UCSBRoboticsClub/ViaCar-2015/cad/Imported Components/viacarbracket2/viacarbracket2.htm

Autodesk Inventor Translation Report | Friday, April 17, 2015 (7:29 PM)
Source File: | C:\Users\Nick\Documents\GitHub\viacar-2015\CAD\viacarbracket2.SLDPRT
Translator Type: | SolidWorks | Sending System:
Author: |  | Translation Time: | 00:00:00
Options
Import Type: | N/A
Entity Types to Import: | Solids, Surfaces, Wires
Import into Repair Environment: | Yes
Import Assembly as Single Part: | No
Create Surfaces As: | Single Composite Feature
Check Parts during Load: | No
Auto Stitch: | No
Enable Advanced Healing: | N/A
+/- | Name | Inventor File | Status
[+] [-] | viacarbracket2.ipt | C:\Users\Nick\Documents\GitHub\viacar-2015\CAD\Imported Components\viacarbracket2\viacarbracket2.ipt | Error
Severity | Entity Id | Message
Error | 0 | Translation failed. This version is not supported.
