UCSBRoboticsClub/ViaCar-2015/cad/Flag mount/Assem1.SLDASM

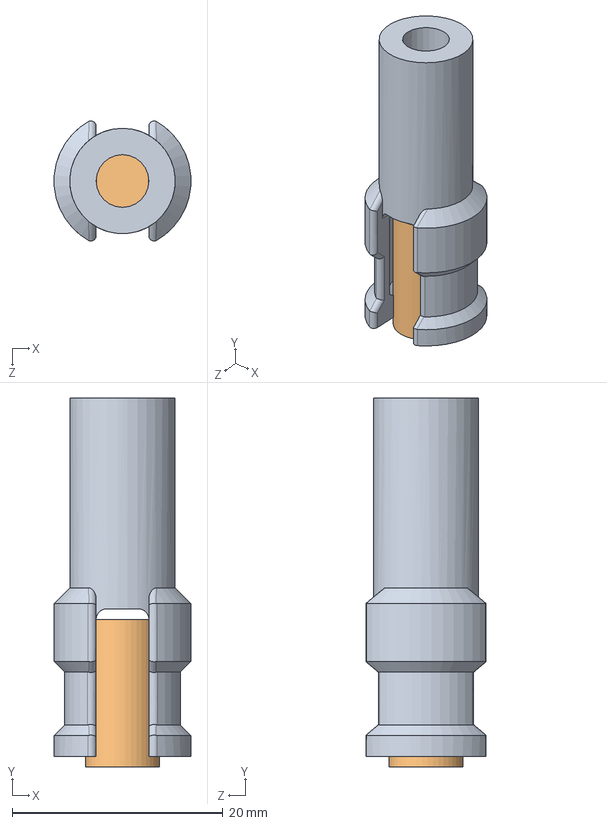
[picture p1: CAD file, 2015-04-11]
cad/Flag mount/Assem1.SLDASM
13.0 x 35.0 x 11.4 mm
flag mount
Switch
