UCSBRoboticsClub/ViaCar-2015/cad/Body to electronics Bracket/main board.SLDPRT

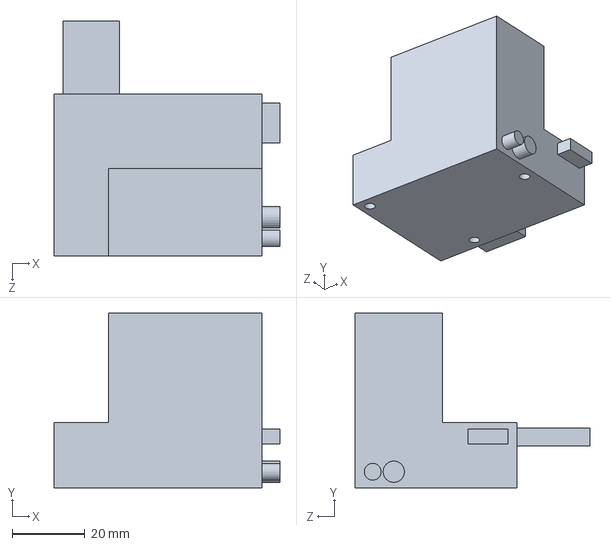
[picture p2: CAD file, 2015-04-11]
cad/Body to electronics Bracket/main board.SLDPRT
62.0 x 48.0 x 64.5 mm
