UCSBRoboticsClub/ViaCar-2015/cad/Body to electronics Bracket/via car loosey goosey.SLDASM

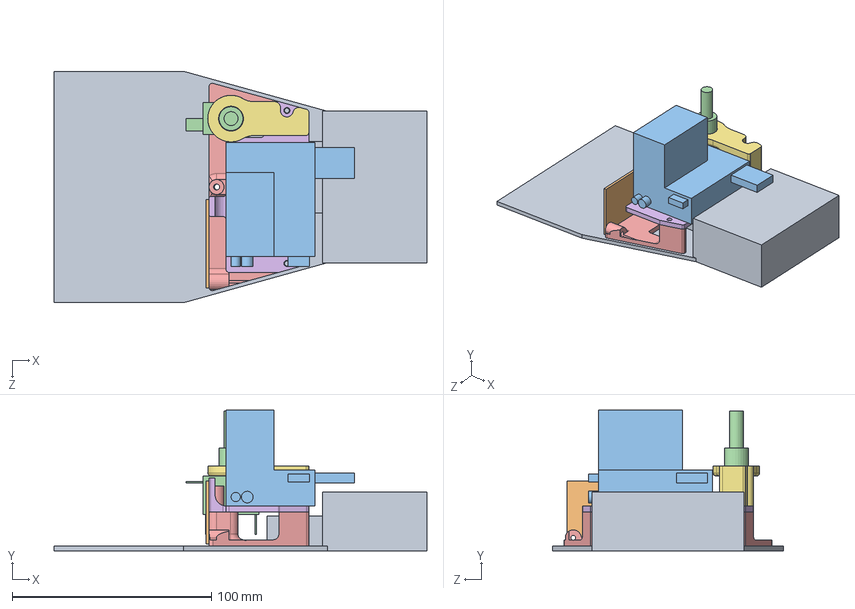
[picture p3: CAD file, 2015-04-11]
cad/Body to electronics Bracket/via car loosey goosey.SLDASM
187.0 x 70.5 x 116.0 mm
Car approximation
motor driver
main board
Kill switch
bracket bottom layer
bracket middle layer
bracket top layer
