UCSBRoboticsClub/ViaCar-2015/cad/Body to electronics Bracket/bracket.SLDPRT

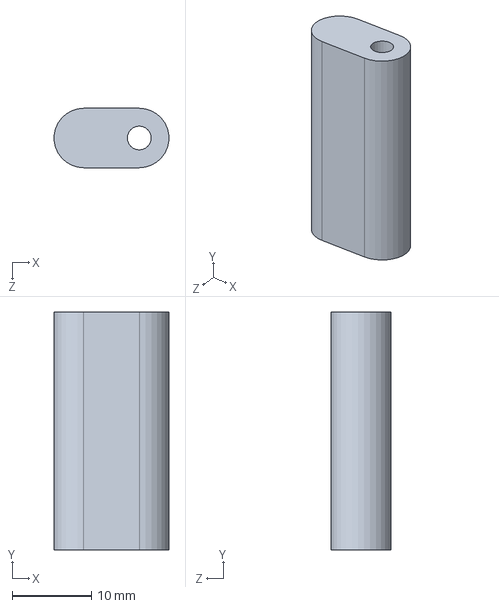
[picture p4: CAD file, 2015-04-11]
cad/Body to electronics Bracket/bracket.SLDPRT
14.5 x 30.0 x 7.50 mm
