UCSBRoboticsClub/ViaCar-2015/cad/Flag mount/flag mount.STEP

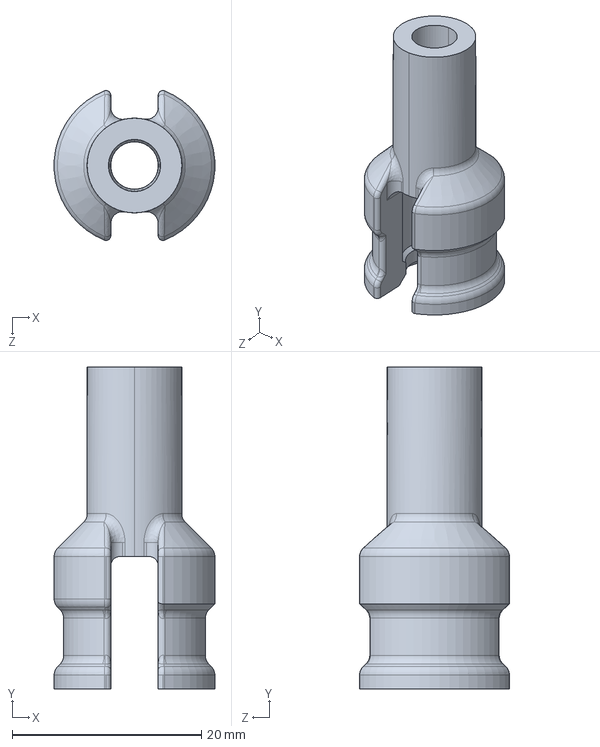
[picture p5: CAD file, 2015-04-18]
cad/Flag mount/flag mount.STEP
17.0 x 34.0 x 15.8 mm
