UCSBRoboticsClub/ViaCar-2015/cad/rulerbracket.STEP

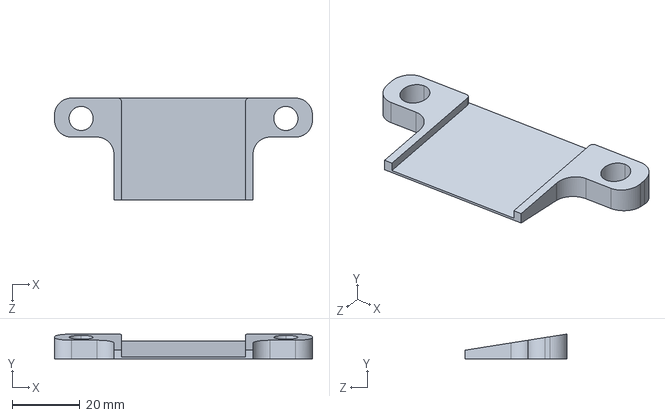
[picture p6: CAD file, 2015-04-18]
cad/rulerbracket.STEP
76.0 x 7.34 x 30.0 mm
