UCSBRoboticsClub/ViaCar-2015/cad/Body to electronics Bracket/Car approximation.SLDPRT

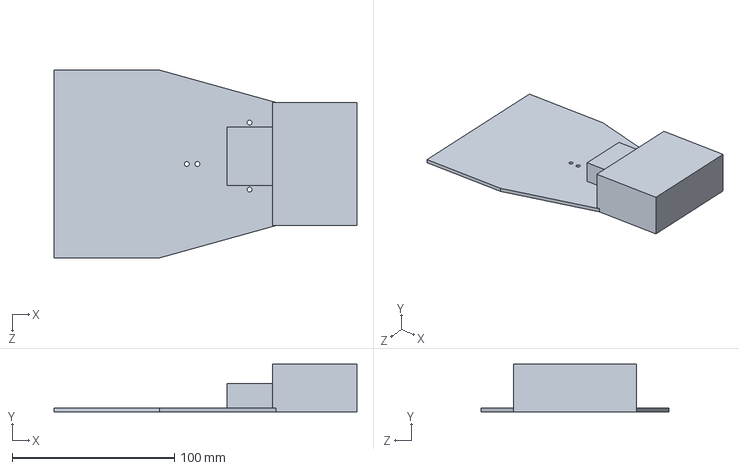
[picture p7: CAD file, 2015-04-11]
cad/Body to electronics Bracket/Car approximation.SLDPRT
187.0 x 29.5 x 116.0 mm
