UCSBRoboticsClub/ViaCar-2015/cad/viacarbracket2.SLDPRT

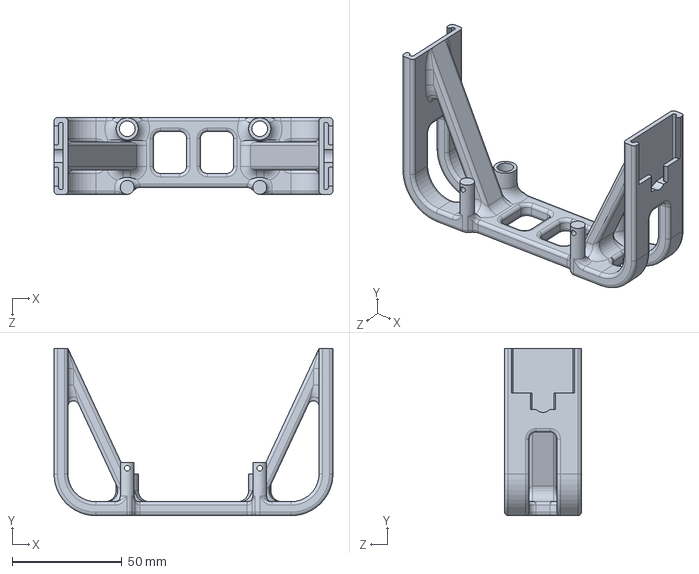
[picture p8: CAD file, 2015-04-07]
cad/viacarbracket2.SLDPRT
127.0 x 76.2 x 34.9 mm
