UCSBRoboticsClub/ViaCar-2015/cad/Body to electronics Bracket/bracket bottom layer.STEP

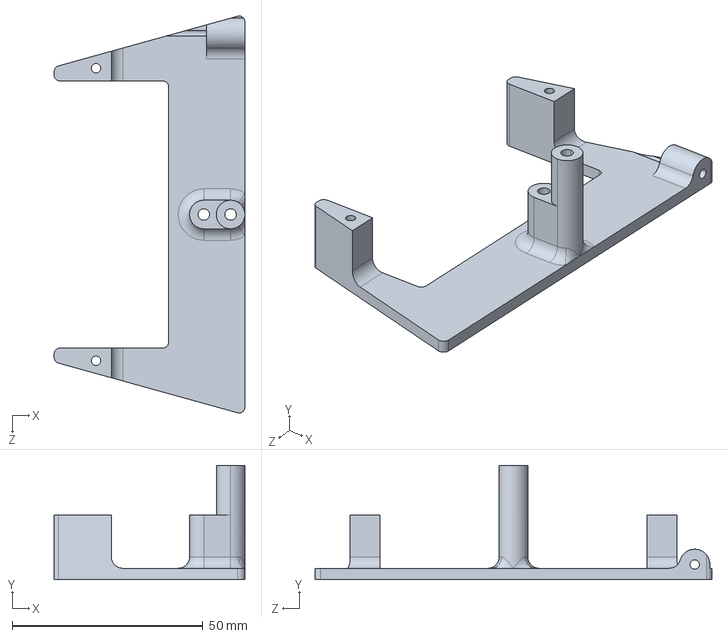
[picture p9: CAD file, 2015-04-11]
cad/Body to electronics Bracket/bracket bottom layer.STEP
50.0 x 30.0 x 104.1 mm
