UCSBRoboticsClub/ViaCar-2015/cad/Flag mount/Switch.SLDPRT

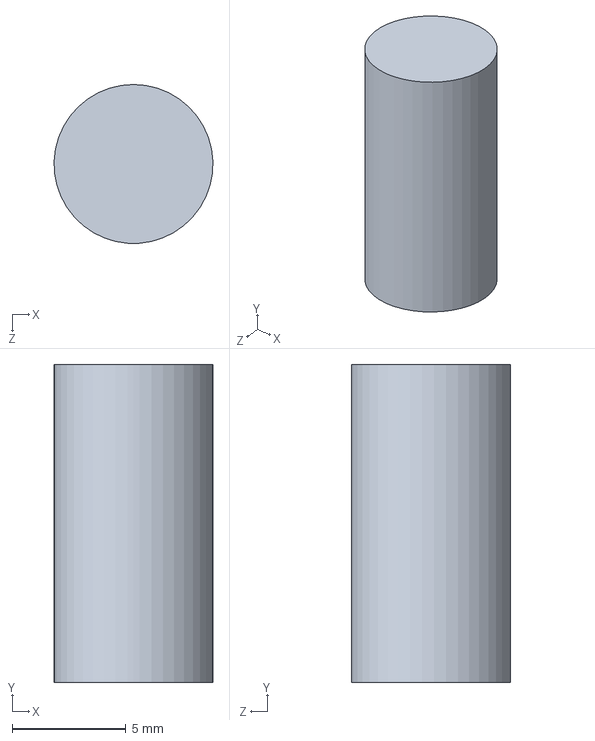
[picture p10: CAD file, 2015-04-11]
cad/Flag mount/Switch.SLDPRT
6.99 x 14.0 x 7.00 mm
