UCSBRoboticsClub/ViaCar-2015/cad/viacarbracket.stl

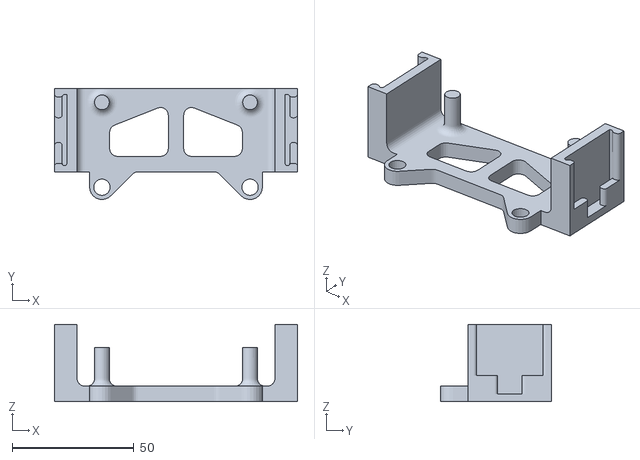
[picture p11: CAD file, 2015-04-05]
cad/viacarbracket.stl
100.0 x 45.7 x 31.8
