UCSBRoboticsClub/ViaCar-2015/cad/Body to electronics Bracket/motor driver.SLDPRT

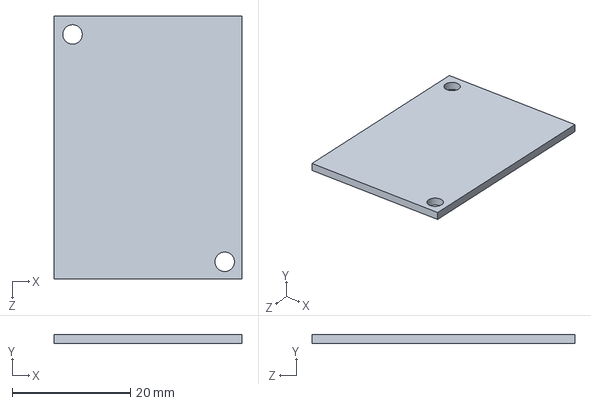
[picture p12: CAD file, 2015-04-11]
cad/Body to electronics Bracket/motor driver.SLDPRT
31.7 x 1.60 x 44.4 mm
