UCSBRoboticsClub/ViaCar-2015/cad/Body to electronics Bracket/Kill switch.SLDPRT

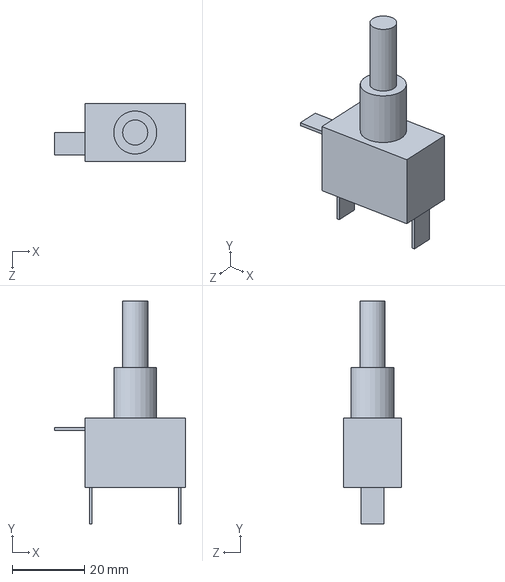
[picture p13: CAD file, 2015-04-11]
cad/Body to electronics Bracket/Kill switch.SLDPRT
36.4 x 61.9 x 16.0 mm
