UCSBRoboticsClub/ViaCar-2015/cad/Body to electronics Bracket/bracket top layer.STEP

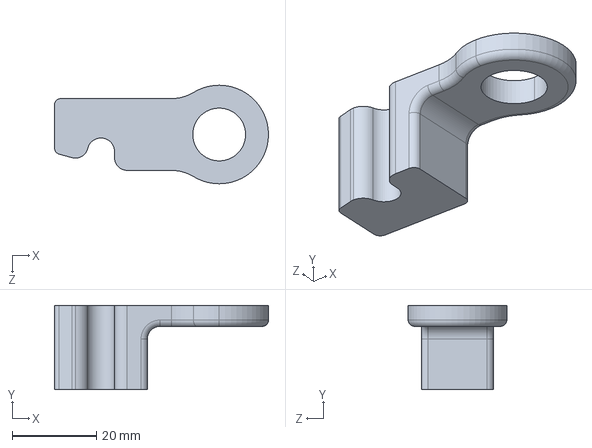
[picture p14: CAD file, 2015-04-11]
cad/Body to electronics Bracket/bracket top layer.STEP
50.7 x 20.0 x 23.3 mm
