UCSBRoboticsClub/ViaCar-2015/cad/Body to electronics Bracket/bracket middle layer.STEP

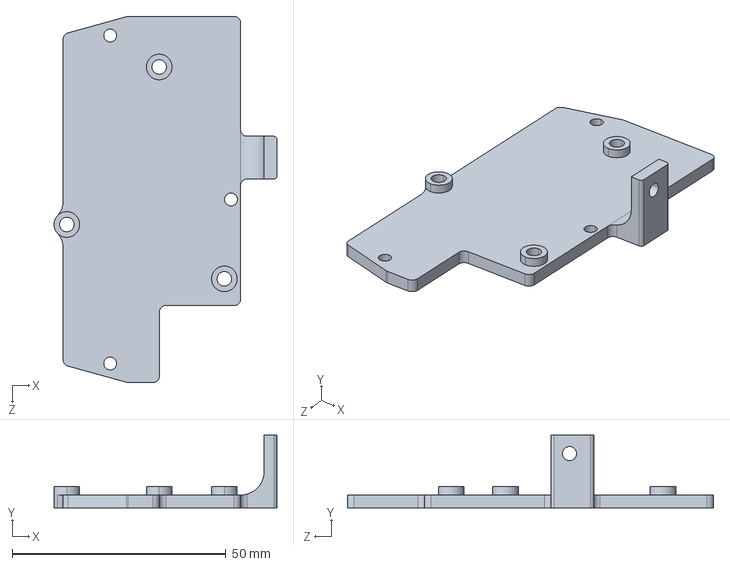
[picture p15: CAD file, 2015-04-11]
cad/Body to electronics Bracket/bracket middle layer.STEP
52.1 x 17.0 x 85.6 mm
