UCSBRoboticsClub/ViaCar-2015/(list of files, cad)

Other CAD files:
cad/Body to electronics Bracket/bracket bottom layer.SLDPRT
cad/Body to electronics Bracket/bracket bottom layer.stl
cad/Body to electronics Bracket/bracket middle layer.SLDPRT
cad/Body to electronics Bracket/bracket middle layer.stl
cad/Body to electronics Bracket/bracket top layer.SLDPRT
cad/Body to electronics Bracket/bracket top layer.stl
cad/Flag mount/flag mount.SLDPRT
cad/Flag mount/flag mount.STL
cad/rulerbracket.SLDPRT
cad/rulerbracket.STL
cad/viacarbracket2.STL
