UCSBRoboticsClub/ViaCar-2015/pcb/signalgen.brd

## EAGLE design pcb/signalgen.brd (2015-04-11)

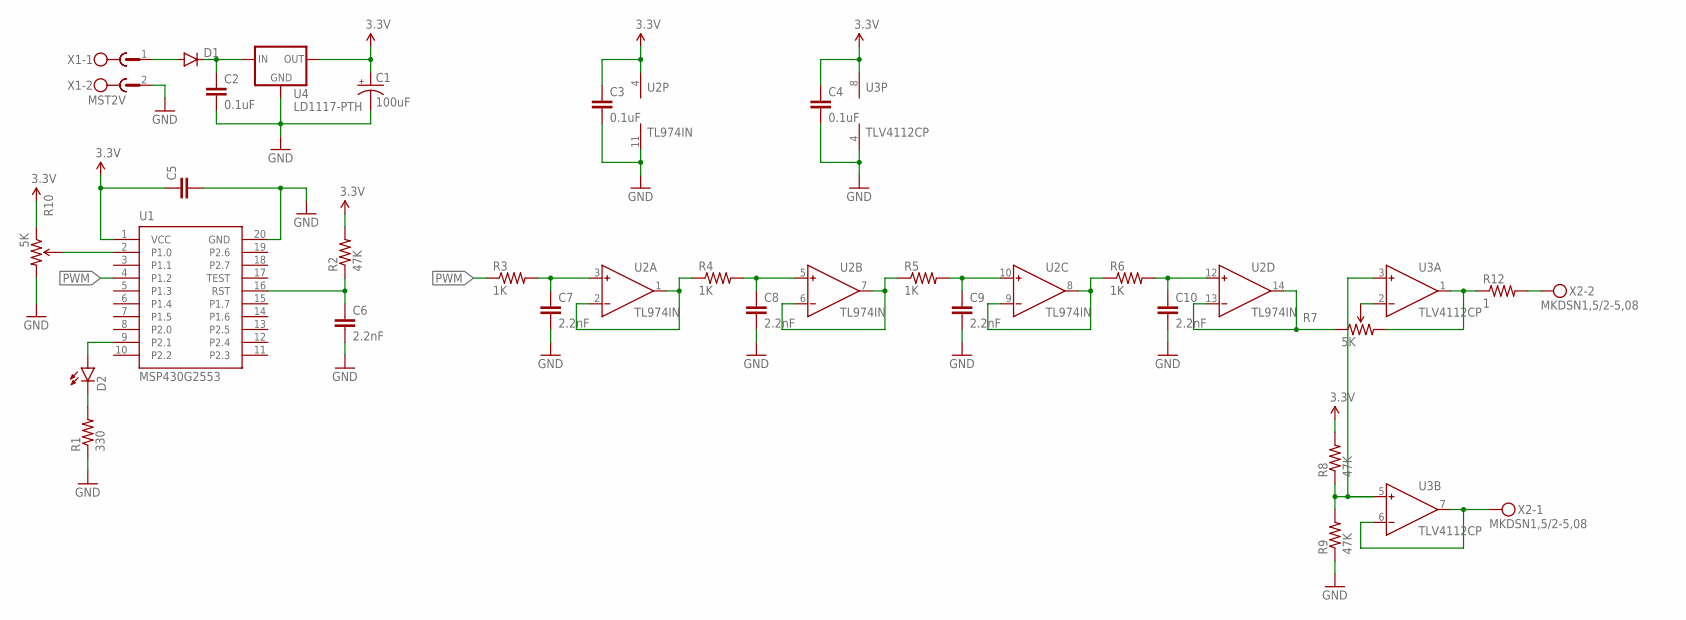
[picture p16: schematic signalgen.sch]

Parts:
C1: 100uF; CPOL-RADIAL-100UF-25V
C2, C3, C4: 0.1uF; CAP-PTH-SMALL
C5: CAPPTH; CAP-PTH-SMALL
C6, C7, C8, C9, C10: 2.2nF; CAP-PTH-SMALL
D1: DIODEPTH; DIODE-1N4001
D2: LED-3MM-NO_SILK; LED3MM-NS
R1: 330; AXIAL-0.1
R2, R8, R9: 47K; AXIAL-0.3
R3, R5: 1K; AXIAL-0.1
R4, R6: 1K; AXIAL-0.3
R7, R10: 5K; TRIM_POT_PTH
R12: 1; AXIAL-0.6
U1: MSP430G2553; DIP-20
U2: TL974IN; DIP-14
U3: TLV4112CP; DIP-8
U4: LD1117-PTH; TO-220ABS
X1: MST2V; MSTBV2
X2: MKDSN1,5/2-5,08

Connections:
3.3V: C1.1 (+), C3.1, C4.1, C5.1, R2.P$2 (2), R8.P$2 (2), R10.1 (CCW), U1.1 (VCC), U2.4 (V+), U3.8 (V+), U4.2 (OUT)
GND: C1.2 (-), C2.2, C3.2, C4.2, C5.2, C6.2, C7.2, C8.2, C9.2, C10.2, R1.P$1 (1), R9.P$1 (1), R10.3 (CW), U1.20 (GND), U2.11 (V-), U3.4 (V-), U4.1 (GND), X1.2
unnamed: D1.A, X1.1
unnamed: C2.1, D1.C, U4.3 (IN)
unnamed: D2.K (C), R1.P$2 (2)
unnamed: R4.P$1 (1), U2.1 (OUT), U2.2 (IN-)
unnamed: C7.1, R3.P$2 (2), U2.3 (IN+)
unnamed: R5.P$1 (1), U2.6 (IN-), U2.7 (OUT)
unnamed: C6.1, R2.P$1 (1), U1.16 (RST)
unnamed: U3.6 (IN-), U3.7 (OUT), X2.1
unnamed: C8.1, R4.P$2 (2), U2.5 (IN+)
unnamed: C10.1, R6.P$2 (2), U2.12 (IN+)
unnamed: R12.P$2 (2), X2.2
unnamed: C9.1, R5.P$2 (2), U2.10 (IN+)
unnamed: R6.P$1 (1), U2.8 (OUT), U2.9 (IN-)
unnamed: R7.1 (CCW), U2.13 (IN-), U2.14 (OUT)
unnamed: R8.P$1 (1), R9.P$2 (2), U3.3 (IN+), U3.5 (IN+)
unnamed: R7.3 (CW), R12.P$1 (1), U3.1 (OUT)
unnamed: R10.2 (WIPER), U1.2 (P1.0)
unnamed: R7.2 (WIPER), U3.2 (IN-)
unnamed: D2.A, U1.9 (P2.1)
PWM: R3.P$1 (1), U1.4 (P1.2)

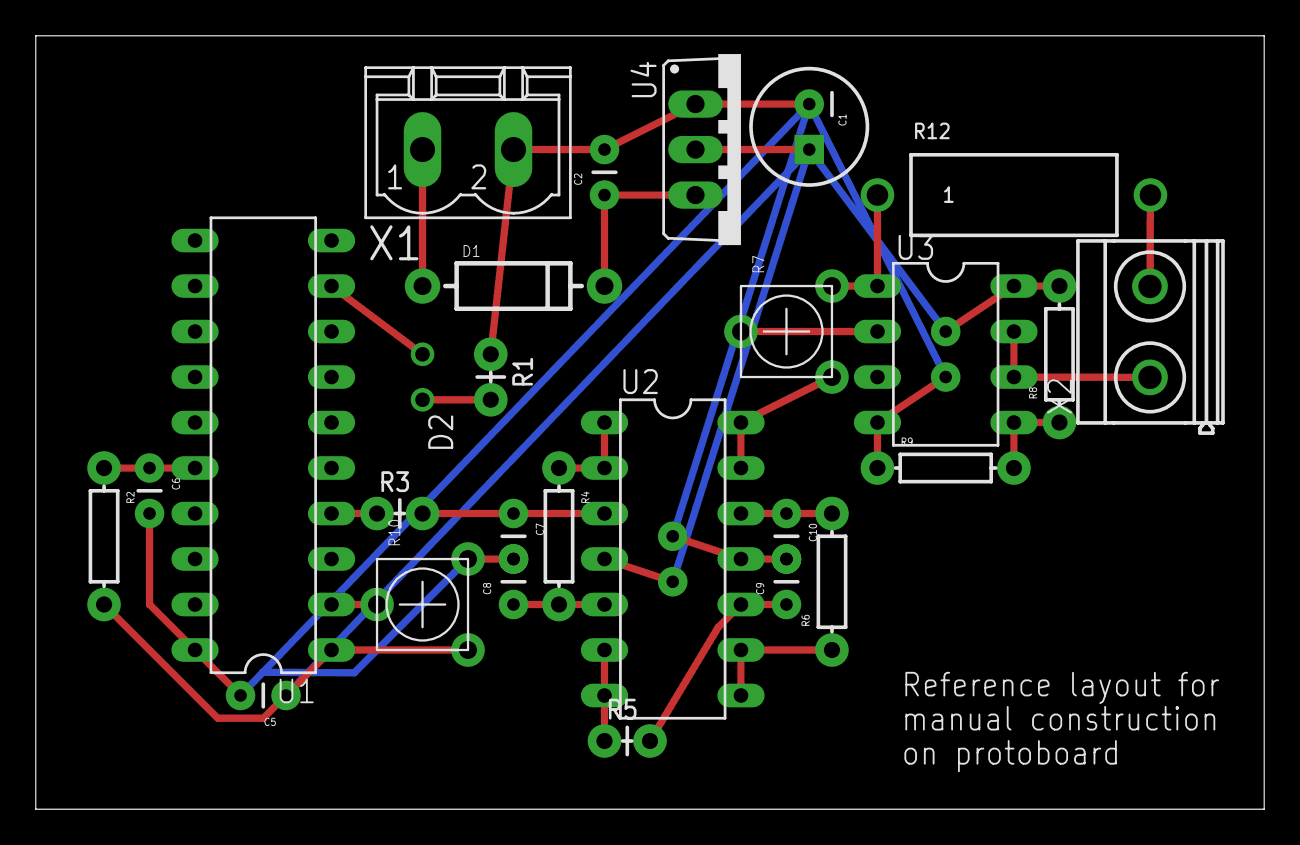
[picture p17: board signalgen.brd from above]

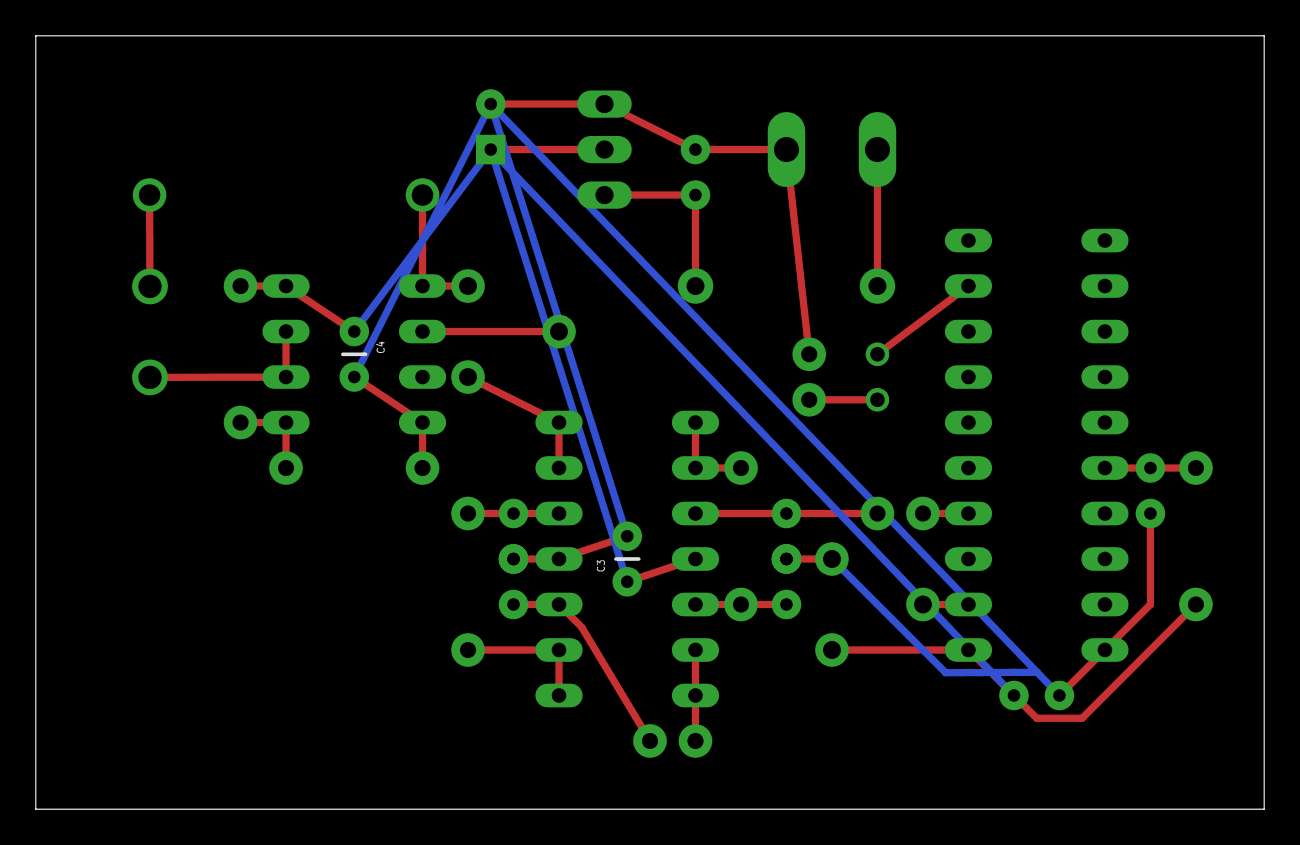
[picture p18: board signalgen.brd from below]

Board: 2 copper layers, 68.6 x 43.2 mm, 29 parts (2 on the bottom side), 22 nets.
