UCSBRoboticsClub/ViaCar-2015/pcb/logic.brd

## EAGLE design pcb/logic.brd (2015-04-07)

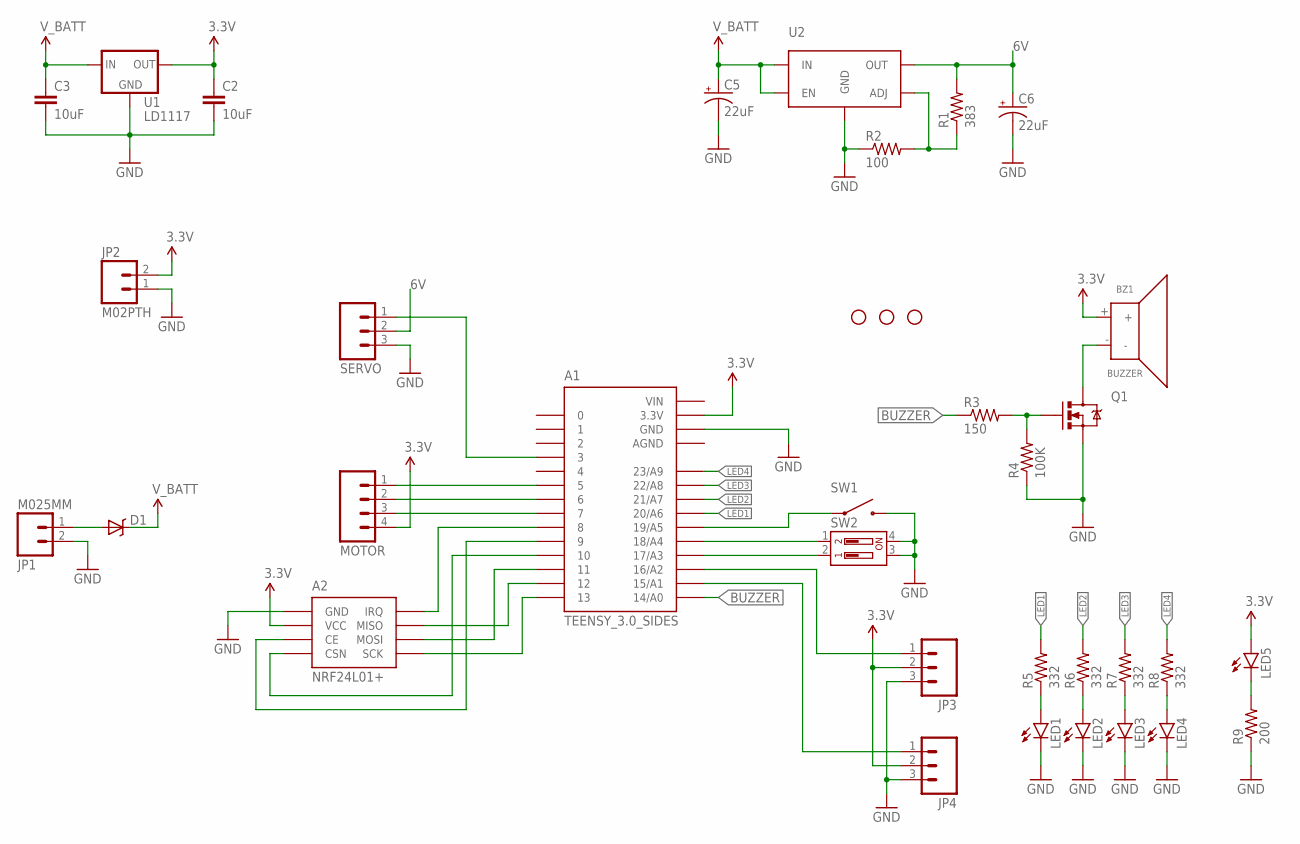
[picture p19: schematic logic.sch]

Parts:
A1: TEENSY_3.0_SIDES
A2: NRF24L01+
BZ1: BUZZER
C2, C3: 10uF; 1206
C5, C6: 22uF; CPOL-RADIAL-10UF-25V
D1: DIODE-SCHOTTKY_; SMA-DIODE
JP1: M025MM; SCREWTERMINAL-5MM-2
JP2: M02PTH; 1X02
JP3, JP4: M03LOCK; 1X03_LOCK
LED1, LED2, LED3, LED4, LED5: LED0603; LED-0603
MOTOR: M04LOCK; 1X04_LOCK
Q1: MOSFET-NCHANNELBSS123LT1G; SOT23-3
R1: 383; 0603-RES
R2: 100; 0603-RES
R3: 150; 0603-RES
R4: 100K; 0603-RES
R5, R6, R7, R8: 332; 0603-RES
R9: 200; 0603-RES
SERVO: M03LOCK_LONGPADS; 1X03_LOCK_LONGPADS
STANDOFF1, STANDOFF2, STANDOFF3: STAND-OFF
SW1: FSM4JSMA
SW2: 2-POS-DIPCTS-THRU-HOLE; 209-2LPST
U1: LD1117; SOT-223
U2: MIC29302AWD; TO-252-5

Connections:
3.3V: A1.3.3V, A2.2 (VCC), BZ1.+, C2.1, JP2.2, JP3.2, JP4.2, LED5.A, MOTOR.4, U1.2 (OUT), U1.4 (OUT)
6V: C6.1 (+), R1.2, SERVO.2, U2.P$4 (OUT)
AGND: A1.AGND
BUZZER: A1.14/A0, R3.1
GND: A1.GND, A2.1 (GND), C2.2, C3.2, C5.2 (-), C6.2 (-), JP1.2, JP2.1, JP3.3, JP4.3, LED1.C, LED2.C, LED3.C, LED4.C, Q1.2 (S), R2.1, R4.1, R9.1, SERVO.3, SW1.3 (2), SW1.4 (2), SW2.3, SW2.4, U1.1 (GND), U2.P$3 (GND), U2.PAD (GND)
LED1: A1.20/A6, R5.2
LED2: A1.21/A7, R6.2
LED3: A1.22/A8, R7.2
LED4: A1.23/A9, R8.2
unnamed: D1.A, JP1.1
unnamed: A1.16/A2, JP3.1
unnamed: A1.15/A1, JP4.1
unnamed: R1.1, R2.2, U2.P$5 (ADJ)
unnamed: A1.13, A2.5 (SCK)
unnamed: A1.12, A2.7 (MISO)
unnamed: A1.11, A2.6 (MOSI)
unnamed: A1.10, A2.4 (CSN)
unnamed: A1.8, A2.8 (IRQ)
unnamed: A1.9, A2.3 (CE)
unnamed: A1.3, SERVO.1
unnamed: BZ1.-, Q1.3 (D)
unnamed: Q1.1 (G), R3.2, R4.2
unnamed: LED4.A, R8.1
unnamed: A1.5, MOTOR.1
unnamed: A1.6, MOTOR.2
unnamed: A1.7, MOTOR.3
unnamed: A1.19/A5, SW1.1, SW1.2 (1)
unnamed: A1.18/A4, SW2.1
unnamed: A1.17/A3, SW2.2
unnamed: LED3.A, R7.1
unnamed: LED2.A, R6.1
unnamed: LED1.A, R5.1
unnamed: LED5.C, R9.2
VIN: A1.VIN
V_BATT: C3.1, C5.1 (+), D1.C, U1.3 (IN), U2.P$1 (EN), U2.P$2 (IN)

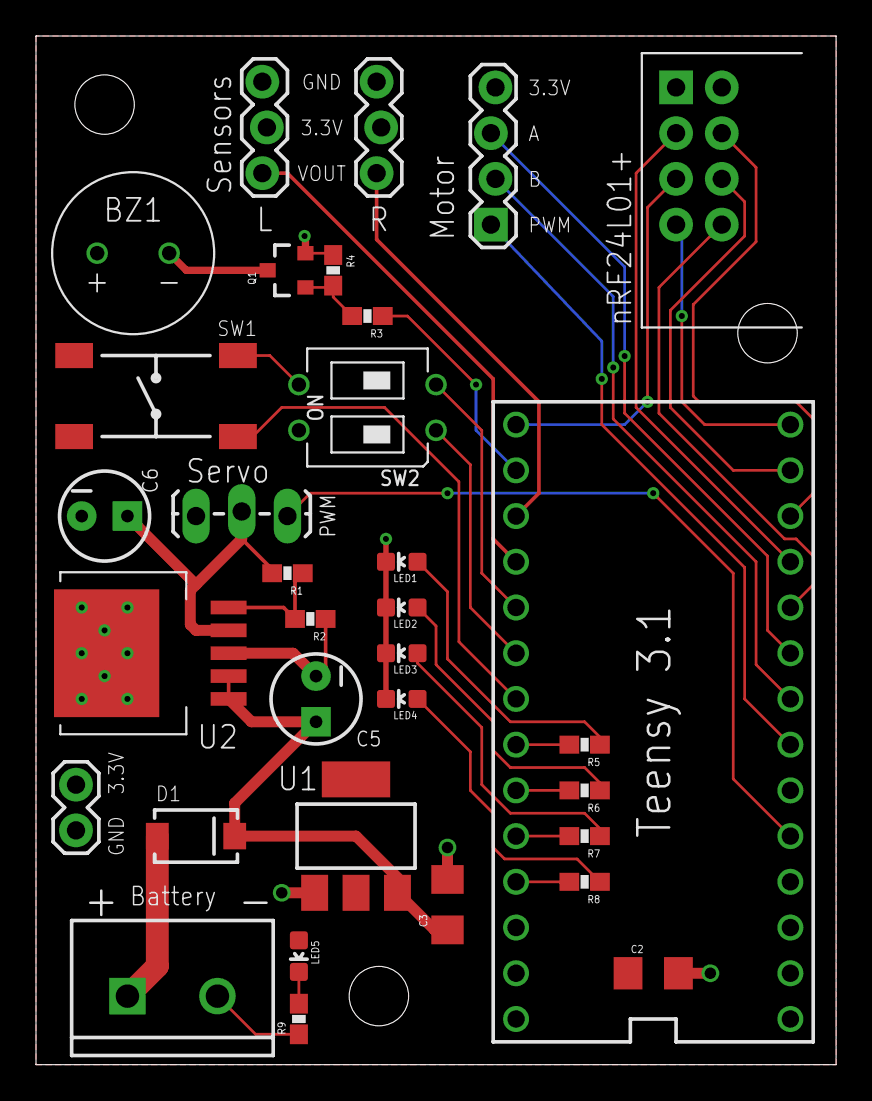
[picture p20: board logic.brd from above]

Board: 2 copper layers, 44.5 x 57.1 mm, 36 parts (0 on the bottom side), 33 nets.
