UCSBRoboticsClub/ViaCar-2015/Adam's ESC/ESC/viaCar.brd

## EAGLE design Adam's ESC/ESC/viaCar.brd (2015-03-14)

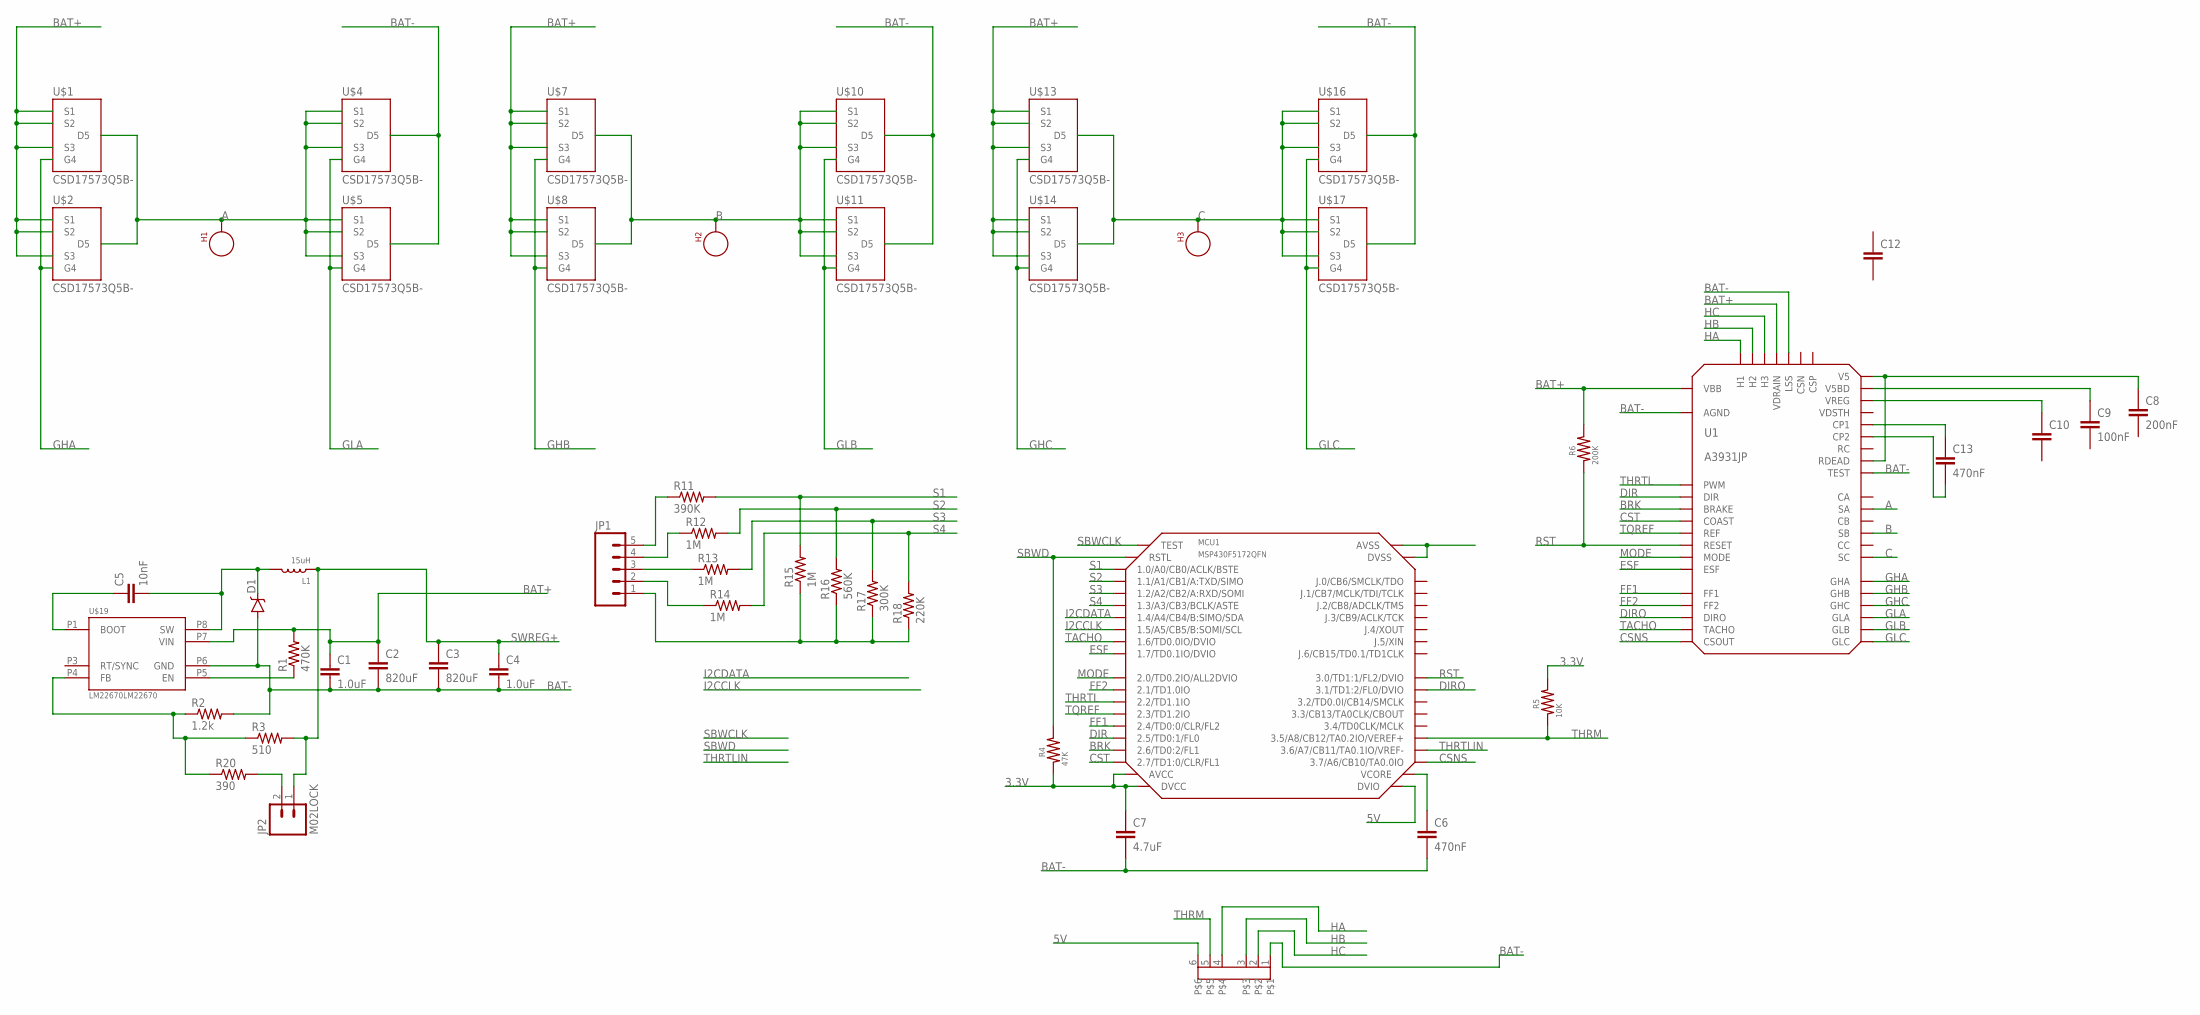
[picture p21: schematic viaCar.sch]

Parts:
C1, C4: 1.0uF; 0603-CAP
C2, C3: 820uF; CHEMI-CON_K30_CAPACITOR
C5: 10nF; 0603-CAP
C6, C13: 470nF; 0603
C7: 4.7uF; 0603
C8: 200nF; 0603
C9: 100nF; 0603
C10, C12: 0603CAP-1; 0603
D1: NXPPMEG45A10EPDSCHOTTKY; CFP15
H1, H2, H3: SEW_HOLE; SIMPLE_HOLE
JP1: M05LOCK; 1X05_LOCK
JP2: M02LOCK; 1X02_LOCK
L1: 15uH; WURTH_WE-PD_INDUCTOR
MCU1: MSP430F5172QFN; QFN-40
R1: 470K; 0603-RES
R2: 1.2k; 0603-RES
R3: 510; 0603-RES
R4: 47K; 0603
R5: 10K; 0603
R6: 200K; 0603
R11: 390K; 0603-RES
R12, R13, R14, R15: 1M; 0603-RES
R16: 560K; 0603-RES
R17: 300K; 0603-RES
R18: 220K; 0603-RES
R20: 390; 0603-RES
U1: A3931JP; LQFP-48
U$1, U$2, U$4, U$5, U$7, U$8, U$10, U$11, U$13, U$14, U$16, U$17: CSD17573Q5B-; SON5X6
U$19: LM22670LM22670; POWERPAD8
U$23: JST6X1.5; JST1.5X6

Connections:
3.3V: C7.P$1 (1), MCU1.P27 (DVCC), MCU1.P37 (AVCC), R4.P$1, R5.P$2
5V: MCU1.P17 (DVIO), U$23.6
A: H1.P$1, U1.P31 (SA), U$1.5 (D5), U$2.5 (D5), U$4.1 (S1), U$4.2 (S2), U$4.3 (S3), U$5.1 (S1), U$5.2 (S2), U$5.3 (S3)
B: H2.P$1, U1.P28 (SB), U$7.5 (D5), U$8.5 (D5), U$10.1 (S1), U$10.2 (S2), U$10.3 (S3), U$11.1 (S1), U$11.2 (S2), U$11.3 (S3)
BAT+: C1.1, C2.P$1 (1), R1.2, R6.P$2, U1.P24 (VDRAIN), U1.P45 (VBB), U$1.1 (S1), U$1.2 (S2), U$1.3 (S3), U$2.1 (S1), U$2.2 (S2), U$2.3 (S3), U$7.1 (S1), U$7.2 (S2), U$7.3 (S3), U$8.1 (S1), U$8.2 (S2), U$8.3 (S3), U$13.1 (S1), U$13.2 (S2), U$13.3 (S3), U$14.1 (S1), U$14.2 (S2), U$14.3 (S3), U$19.P7 (VIN)
BAT-: C1.2, C2.P$2 (2), C3.P$2 (2), C4.2, C6.P$2 (2), C7.P$2 (2), D1.P$1 (A), D1.P$2 (A), R2.2, U1.P17 (TEST), U1.P38 (LSS), U1.P41 (AGND), U1.THRM (AGND), U$4.5 (D5), U$5.5 (D5), U$10.5 (D5), U$11.5 (D5), U$16.5 (D5), U$17.5 (D5), U$19.P6 (GND), U$23.1
BRK: U1.P8 (BRAKE)
C: H3.P$1, U1.P25 (SC), U$13.5 (D5), U$14.5 (D5), U$16.1 (S1), U$16.2 (S2), U$16.3 (S3), U$17.1 (S1), U$17.2 (S2), U$17.3 (S3)
CSNS: U1.P19 (CSOUT)
CST: U1.P46 (COAST)
DIR: U1.P9 (DIR)
DIRO: MCU1.P24 (3.1/TD1:2/FL0/DVIO), U1.P44 (DIRO)
ESF: U1.P39 (ESF)
FF1: MCU1.P19 (2.4/TD0:0/CLR/FL2), U1.P6 (FF1)
FF2: MCU1.P14 (2.1/TD1.0IO), U1.P5 (FF2)
GHA: U1.P32 (GHA), U$1.4 (G4), U$2.4 (G4)
GHB: U1.P29 (GHB), U$7.4 (G4), U$8.4 (G4)
GHC: U1.P26 (GHC), U$13.4 (G4), U$14.4 (G4)
GLA: U1.P36 (GLA), U$4.4 (G4), U$5.4 (G4)
GLB: U1.P35 (GLB), U$10.4 (G4), U$11.4 (G4)
GLC: U1.P34 (GLC), U$16.4 (G4), U$17.4 (G4)
HA: U1.P10 (H1), U$23.4
HB: U1.P11 (H2), U$23.3
HC: U1.P12 (H3), U$23.2
I2CCLK: MCU1.P6 (1.5/A5/CB5/B:SOMI/SCL)
I2CDATA: MCU1.P5 (1.4/A4/CB4/B:SIMO/SDA)
MODE: U1.P15 (MODE)
unnamed: C6.P$1 (1), MCU1.P25 (VCORE)
unnamed: C5.2, D1.P$3 (C), L1.P$1, U$19.P8 (SW)
unnamed: C5.1, U$19.P1 (BOOT)
unnamed: MCU1.P18 (DVSS), MCU1.P26 (DVSS), MCU1.P40 (AVSS), MCU1.P$42 (DVSS), MCU1.P$43 (DVSS), MCU1.P$44 (DVSS), MCU1.P$45 (DVSS), MCU1.P$46 (DVSS), MCU1.P$47 (DVSS), MCU1.P$48 (DVSS), MCU1.P$49 (DVSS), MCU1.P$50 (DVSS), MCU1.P$51 (DVSS), MCU1.P$52 (DVSS), MCU1.P$53 (DVSS), MCU1.P$54 (DVSS), MCU1.P$55 (DVSS), MCU1.P$56 (DVSS), MCU1.P$57 (DVSS), MCU1.P$58 (DVSS), MCU1.P$59 (DVSS), MCU1.P$60 (DVSS), MCU1.P$61 (DVSS), MCU1.P$62 (DVSS), MCU1.P$63 (DVSS), MCU1.P$64 (DVSS), MCU1.P$65 (DVSS), MCU1.P$66 (DVSS), MCU1.THRM (DVSS)
unnamed: C8.P$1 (1), U1.P4 (V5), U1.P18 (RDEAD)
unnamed: R1.1, U$19.P5 (EN)
unnamed: R2.1, R3.1, R20.1, U$19.P4 (FB)
unnamed: C9.P$1 (1), U1.P3 (V5BD)
unnamed: C10.P$1 (1), U1.P40 (VREG)
unnamed: C13.P$1 (1), U1.P42 (CP1)
unnamed: C13.P$2 (2), U1.P43 (CP2)
unnamed: JP1.5, R11.1
unnamed: JP1.4, R12.1
unnamed: JP1.3, R13.1
unnamed: JP1.2, R14.1
unnamed: JP2.2, R20.2
unnamed: JP1.1, R15.1, R16.1, R17.1, R18.1
RST: R6.P$1, U1.P2 (RESET)
S1: MCU1.P1 (1.0/A0/CB0/ACLK/BSTE), R11.2, R15.2
S2: MCU1.P2 (1.1/A1/CB1/A:TXD/SIMO), R12.2, R16.2
S3: MCU1.P3 (1.2/A2/CB2/A:RXD/SOMI), R13.2, R17.2
S4: MCU1.P4 (1.3/A3/CB3/BCLK/ASTE), R14.2, R18.2
SBWCLK: MCU1.P32 (TEST)
SBWD: MCU1.P33 (RSTL), R4.P$2
SWREG+: C3.P$1 (1), C4.1, JP2.1, L1.P$2, R3.2
TACHO: MCU1.P11 (1.6/TD0.0IO/DVIO), U1.P7 (TACHO)
THRM: MCU1.P34 (3.5/A8/CB12/TA0.2IO/VEREF+), R5.P$1, U$23.5
THRTL: U1.P14 (PWM)
THRTLIN: MCU1.P35 (3.6/A7/CB11/TA0.1IO/VREF-)
TQREF: MCU1.P16 (2.3/TD1.2IO), U1.P20 (REF)

Board: 2 copper layers, 50 parts (0 on the bottom side), 46 nets, no tracks yet.
