UCSBRoboticsClub/ViaCar-2015/pcb/indsensor3.brd

## EAGLE design pcb/indsensor3.brd (2015-02-15)

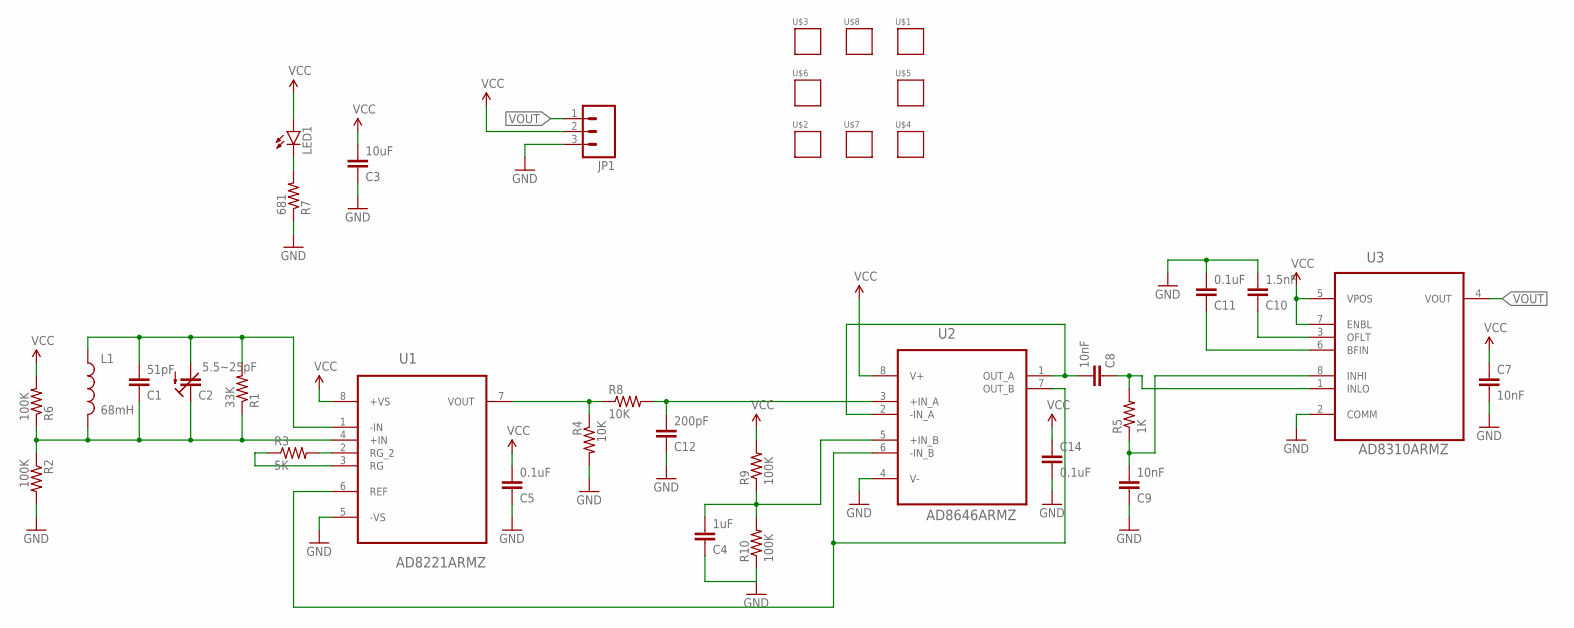
[picture p22: schematic indsensor3.sch]

Parts:
C1: 51pF; 0603-CAP
C2: 5.5~25pF; TRIMCAP-TZY
C3: 10uF; 1206
C4: 1uF; 0603-CAP
C5, C11, C14: 0.1uF; 0603-CAP
C7, C8, C9: 10nF; 0603-CAP
C10: 1.5nF; 0603-CAP
C12: 200pF; 0603-CAP
JP1: M03LOCK; 1X03_LOCK
L1: 68mH; RLB0912
LED1: LED0603; LED-0603
R1: 33K; 0603-RES
R2, R6, R9, R10: 100K; 0603-RES
R3: 5K; 0603-RES
R4, R8: 10K; 0603-RES
R5: 1K; 0603-RES
R7: 681; 0603-RES
U1: AD8221ARMZ; SOP65P490X110-8N
U2: AD8646ARMZ; SOP65P490X110-8N
U3: AD8310ARMZ; SOP65P490X110-8N
U$1, U$2, U$3, U$4: SHIELD-CORNER
U$5, U$6: SHIELD-MIDDLE
U$7: SHIELD-MIDDLEPART
U$8: SHIELD-MIDDLE3

Connections:
10NF: R4.1, R8.1, U1.7 (VOUT)
GND: C3.1, C4.1, C5.1, C7.2, C9.1, C10.2, C11.2, C12.1, C14.2, JP1.3, R2.2, R4.2, R7.1, R10.1, U1.5 (-VS), U2.4 (V-), U3.2 (COMM)
unnamed: R3.2, U1.2 (RG_2)
unnamed: R3.1, U1.3 (RG)
unnamed: C10.1, U3.3 (OFLT)
unnamed: C8.1, R5.2, U3.1 (INLO)
unnamed: C9.2, R5.1, U3.8 (INHI)
unnamed: LED1.C, R7.2
unnamed: C1.1, C2.2 (E), L1.2, R1.1, R2.1, R6.1, U1.4 (+IN)
unnamed: C11.1, U3.6 (BFIN)
unnamed: C8.2, U2.1 (OUT_A), U2.2 (-IN_A)
unnamed: C1.2, C2.1 (A), L1.1, R1.2, U1.1 (-IN)
unnamed: C12.2, R8.2, U2.3 (+IN_A)
unnamed: U1.6 (REF), U2.6 (-IN_B), U2.7 (OUT_B)
unnamed: C4.2, R9.1, R10.2, U2.5 (+IN_B)
VCC: C3.2, C5.2, C7.1, C14.1, JP1.2, LED1.A, R6.2, R9.2, U1.8 (+VS), U2.8 (V+), U3.5 (VPOS), U3.7 (ENBL)
VOUT: JP1.1, U3.4 (VOUT)

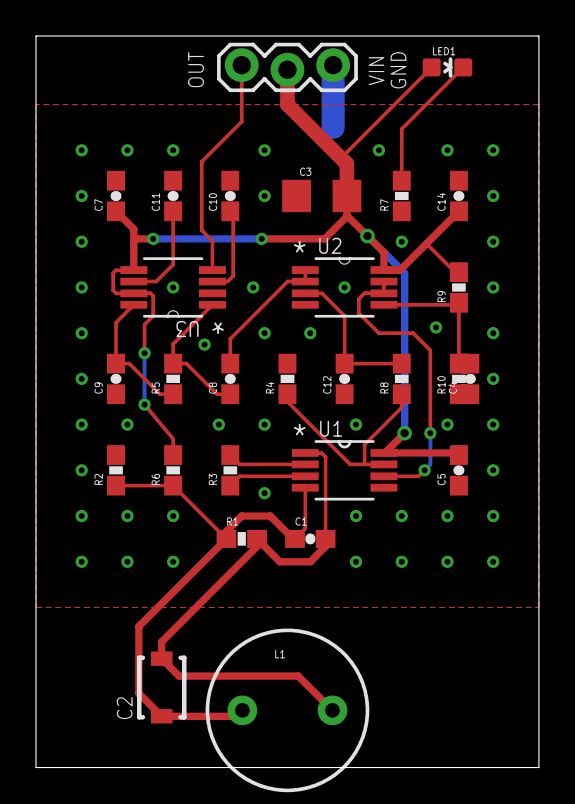
[picture p23: board indsensor3.brd from above]

Board: 2 copper layers, 27.9 x 40.6 mm, 36 parts (0 on the bottom side), 17 nets.
