UCSBRoboticsClub/ViaCar-2015/pcb/indsensor2.brd

## EAGLE design pcb/indsensor2.brd (2015-02-06)

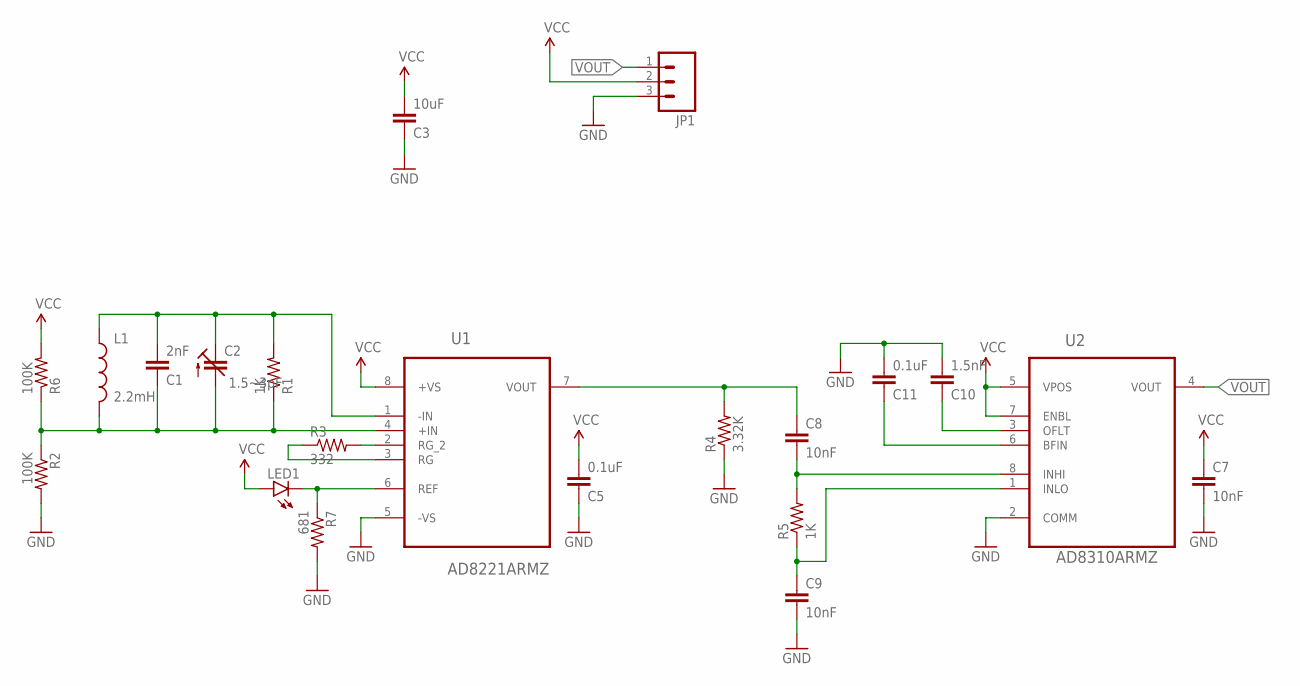
[picture p24: schematic indsensor2.sch]

Parts:
C1: 2nF; 0603-CAP
C2: 1.5~3pF; TRIMCAP-TZY
C3: 10uF; 0603-CAP
C5, C11: 0.1uF; 0603-CAP
C7, C8, C9: 10nF; 0603-CAP
C10: 1.5nF; 0603-CAP
JP1: M03LOCK; 1X03_LOCK
L1: 2.2mH; 1812
LED1: LED0603; LED-0603
R1, R5: 1K; 0603-RES
R2, R6: 100K; 0603-RES
R3: 332; 0603-RES
R4: 3.32K; 0603-RES
R7: 681; 0603-RES
U1: AD8221ARMZ; SOP65P490X110-8N
U2: AD8310ARMZ; SOP65P490X110-8N

Connections:
10NF: C8.1, R4.2, U1.7 (VOUT)
GND: C3.1, C5.1, C7.2, C9.2, C10.2, C11.2, JP1.3, R2.2, R4.1, R7.2, U1.5 (-VS), U2.2 (COMM)
unnamed: R3.2, U1.2 (RG_2)
unnamed: R3.1, U1.3 (RG)
unnamed: C10.1, U2.3 (OFLT)
unnamed: C8.2, R5.2, U2.8 (INHI)
unnamed: C9.1, R5.1, U2.1 (INLO)
unnamed: LED1.C, R7.1, U1.6 (REF)
unnamed: C1.2, C2.2 (E), L1.1, R1.2, U1.1 (-IN)
unnamed: C11.1, U2.6 (BFIN)
unnamed: C1.1, C2.1 (A), L1.2, R1.1, R2.1, R6.1, U1.4 (+IN)
VCC: C3.2, C5.2, C7.1, JP1.2, LED1.A, R6.2, U1.8 (+VS), U2.5 (VPOS), U2.7 (ENBL)
VOUT: JP1.1, U2.4 (VOUT)

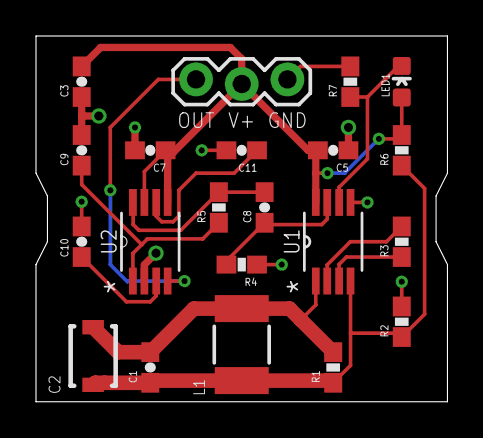
[picture p25: board indsensor2.brd from above]

Board: 2 copper layers, 22.9 x 20.3 mm, 21 parts (0 on the bottom side), 13 nets.
