UCSBRoboticsClub/ViaCar-2015/Viacar2015/Globals.h

#ifndef GLOBALS_H
#define GLOBALS_H

#include <Arduino.h>
#include "./Servo.h"
#include "VNH5019.h"
#include "Button.h"
#include "LowPass.h"
#include "PIDController.h"


const int encoderPin = 2;
const int servoPin = 3;
const int motorSpeedPin = 5;
const int motorBackPin = 6;
const int motorFwdPin = 7;
const int sensorRPin = A1;
const int sensorLPin = A2;
const int buzzerPin = 14;
const int switch2Pin = 17;
const int switch1Pin = 18;
const int buttonPin = 19;
const int led1Pin = 20;
const int led2Pin = 21;
const int led3Pin = 22;
const int led4Pin = 23;

extern float vr;
extern float vl;
extern LowPass xr;
extern LowPass xl;
extern LowPass x;
extern float h;
extern float d;
extern float c1;
extern float c2;
extern float speed;
extern float minSpeed;
extern float speedRef;
extern float speedCtrl;
extern float controllerOut;
extern bool controllerEnabled;
extern float xmax;
extern LowPass minScore;
extern float scoreLimit;
extern float theta;
extern LowPass thetalp;
extern float thetaest;
extern float curvature;
extern LowPass velocity;
extern LowPass accel;
extern volatile uint32_t encCounts;
extern uint32_t lastCounts;

extern Motor motor;
extern Servo servo;
extern Button button;
extern Button switch1;
extern Button switch2;
extern PIDController servoController;
extern PIDController speedController;

const unsigned int controlFreq = 500; // Hz
const unsigned int controlPeriodUs = 1000000 / controlFreq;
const float dt = 1.f / controlFreq;


#endif // GLOBALS_H
