UCSBRoboticsClub/ViaCar-2015/Viacar2015/Button.cpp

#include "Button.h"
#include <Arduino.h>


Button::Button(int pin, bool activeState, bool pullup) :
    pin(pin),
    activeState(activeState),
    edge(false)
{
    pinMode(pin, pullup ? INPUT_PULLUP : INPUT);
    state = digitalRead(pin);
}


void Button::setPullup(bool on)
{
    pinMode(pin, on ? INPUT_PULLUP : INPUT);
}


void Button::update()
{
    bool newState = digitalRead(pin);
    edge = (newState != state);
    state = newState;
}


bool Button::pressed()
{
    return (state == activeState);
}


bool Button::pressEdge()
{
    return (edge && state == activeState);
}


bool Button::releaseEdge()
{
    return (edge && state != activeState);
}
