UCSBRoboticsClub/ViaCar-2015/(commit log)

2015-02-06 Added inductive sensor PCB files
    [indsensor.brd, indsensor.sch, indsensor2.brd, indsensor2.sch, indsensor3.brd, indsensor3.sch]
2015-02-15 Updated component values
    [indsensor3.brd, indsensor3.sch]
2015-03-13 ESC Upload
    esc work thus far.
    [sonPckg.brd, sonPckg.sch, viaCar.brd, viaCar.sch]
2015-03-14 Added PID controller for servo
2015-03-24 Added new logic board
    [logic.brd, logic.sch]
2015-03-24 Minor changes to board
    [logic.brd]
2015-03-26 Fixed resistor values
    [logic.brd, logic.sch]
2015-03-26 Added regulator datasheet
2015-04-05 Changed gain resistor
    [indsensor3.sch]
2015-04-05 Added signal generator schematic and layout
    [signalgen.brd, signalgen.sch]
2015-04-05 Added sensor bracket v1 STL file
    [viacarbracket.stl]
2015-04-07 Updated resistor values
    [logic.brd, logic.sch]
2015-04-07 Added new sensor bracket
    [viacarbracket2.SLDPRT, viacarbracket2.STL]
2015-04-07 Updated code for new board
2015-04-07 Fixed radio pins for new board
2015-04-10 Made cad folder and added the flag mounting bracket
    [Assem1.SLDASM, Car approximation.SLDPRT, Kill switch.SLDPRT, Switch.SLDPRT, bracket bottom layer.SLDPRT, bracket bottom layer.STEP, bracket bottom layer.stl, bracket middle layer.SLDPRT]
2015-04-11 Added a taper to the inside of the shaft hole
    [flag mount.SLDPRT, flag mount.STEP]
2015-04-11 Implemented system linearization
    [signalgen.brd, signalgen.sch]
2015-04-11 ADC library is now included with teensyduio 1.22
2015-04-11 Use a lowpass for velocity estimation
2015-04-13 Controller is no longer time/speed dependant
    [Commands.cpp, Globals.cpp, Globals.h, PIDController.h, Viacar2015.ino]
2015-04-18 Changed size of Flag holder
    Increaded flag shaft size and increased size for strength
    [flag mount.SLDPRT, flag mount.STEP, flag mount.STL]
2015-04-18 Changed flag mount to increase strength and improve fit
2015-04-18 Wheel encoder and more
2015-04-18 Made Ruler Bracket
    [rulerbracket.SLDPRT, rulerbracket.STEP, rulerbracket.STL]
